agnunez/uvc_wc/images/220v_5v_Transformer.jpg

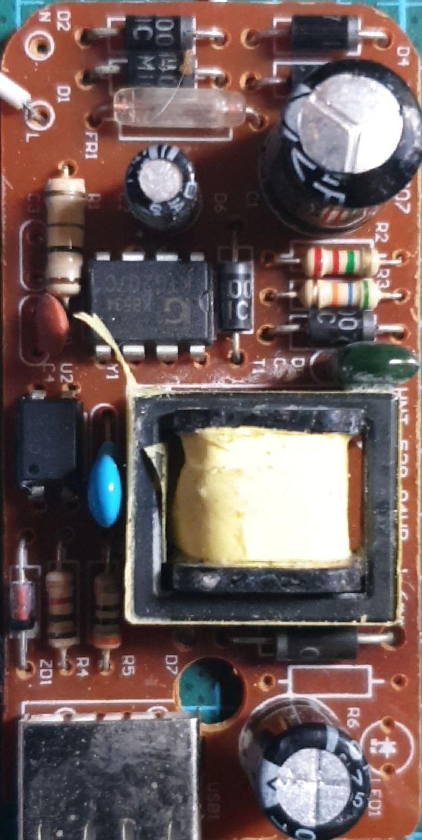
images/220v_5v_Transformer.jpg
