agnunez/uvc_wc/images/NodeMCU.jpg

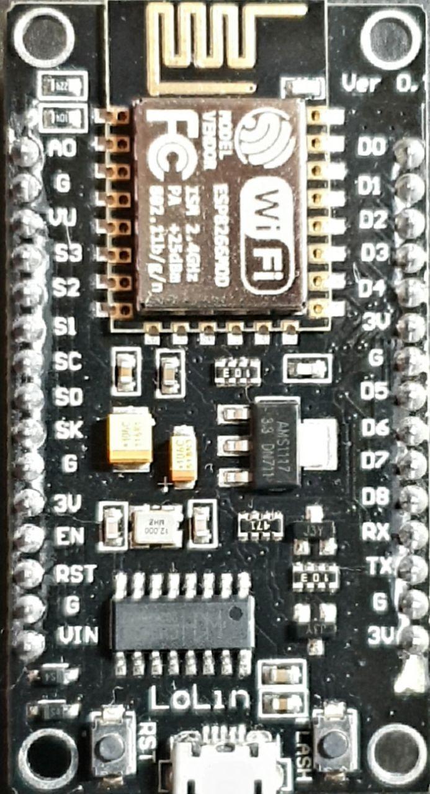
images/NodeMCU.jpg
