agnunez/uvc_wc/(commit log)

2020-06-30 enumerated status bug corrected
    [UVC_WC.ino]
2020-06-30 Image of relay hacking
2020-06-30 avoid effects of millis() rollout
    [UVC_WC.ino]
2020-07-21 Circuit overlay pictures jpg files
2020-07-24 Relay off bug at the end of timer 3 corrected
    [UVC_WC.ino]
